UCSD-E4E/coral-reef-mapping/photos/IMG-0437.JPG

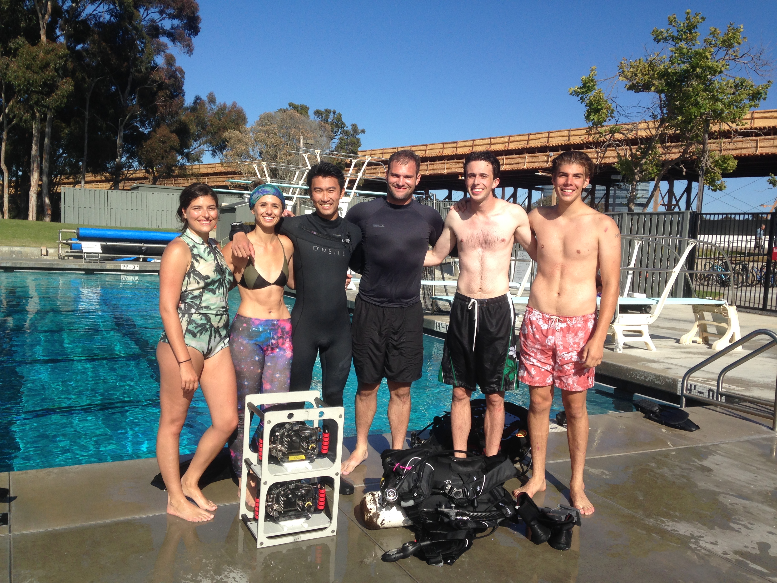
photos/IMG-0437.JPG
