UCSD-E4E/coral-reef-mapping/photos/IMG-0438.JPG

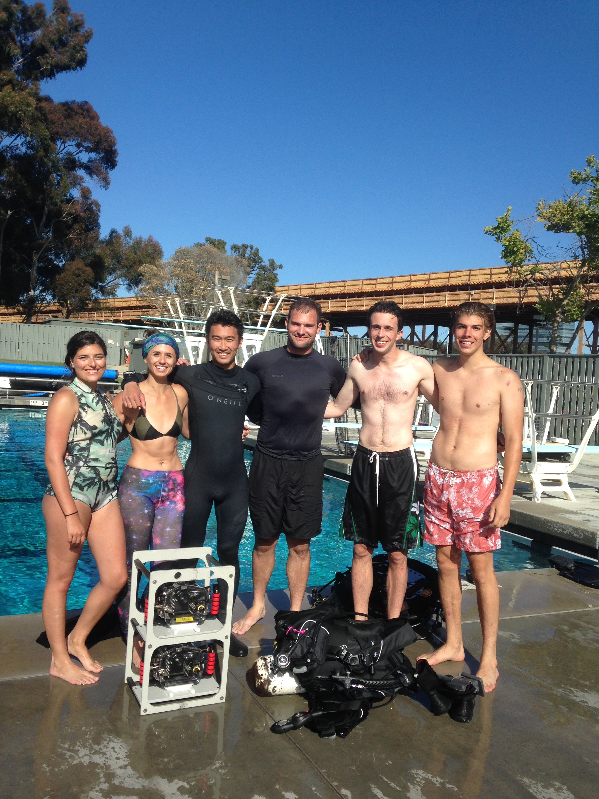
photos/IMG-0438.JPG
