UCSD-E4E/coral-reef-mapping/README.md

# coral-reef-mapping
Underwater depth/heading sensor for use by SIO oceanographers in mapping coral reefs.
