UCSD-E4E/coral-reef-mapping/photos/README.md

Some photos we accumulated. Probably good to keep track of any sort of media we create.
