UCSD-E4E/coral-reef-mapping/hardware/datasheets/README.md

This section contains a bunch of relevant datasheets, as well as other information about using the MSP 430. Datasheets can also be found by going to the various Mouser pages for the parts - URLs can be found on the BOM. Some datasheets are missing; feel free to add them.
