UCSD-E4E/coral-reef-mapping/photos/Overview.pdf

# Reefer

## The

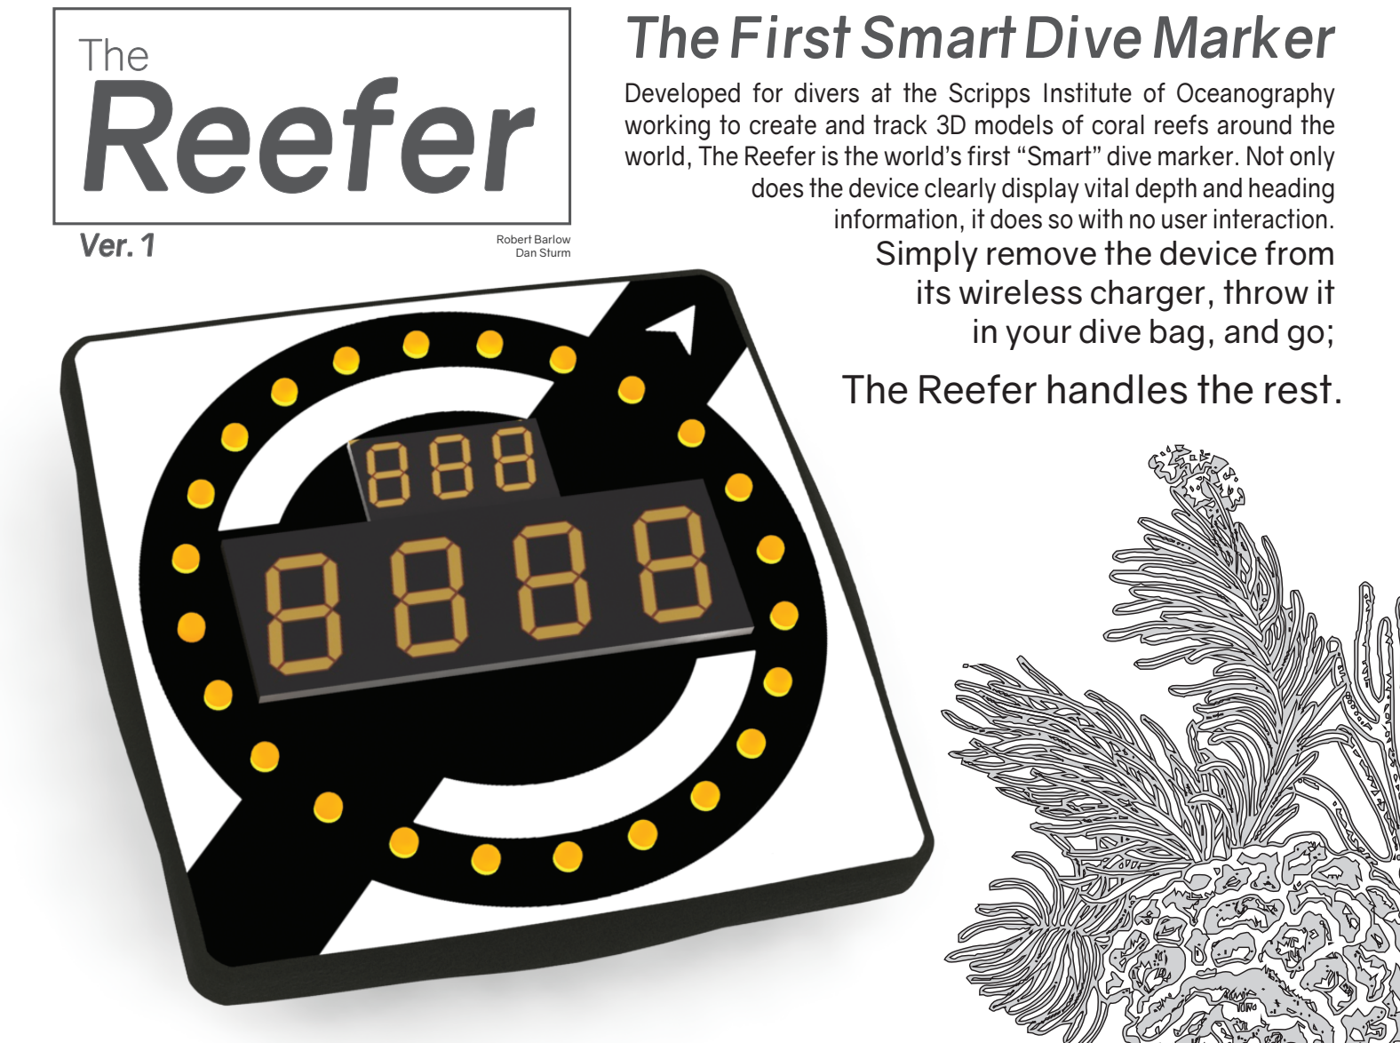
[picture p3: page 1]

Ver. 1 | Robert Barlow Dan Sturm

# The First Smart Dive Marker

Developed for divers at the Scripps Institute of Oceanography working to create and track 3D models of coral reefs around the world, The Reefer is the world’s first “Smart” dive marker. Not only does the device clearly display vital depth and heading information, it does so with no user interaction.

### Simply remove the device from its wireless charger, throw it

in your dive bag, and go;
The Reefer handles the rest.
