UCSD-E4E/coral-reef-mapping/photos/Flow Diagrm.pdf

O

Ultra-low power consumption state. All devices turned o, MSP set to low power mode.

Magnetometer | Pressure

Reed Switch

Magnetometer is disabled Pressure Sensor is disabled

# On (Flux)

Instantaneous depth state. Used when device is in transit from boat to dive location and back.

Magnetometer | Pressure

Reed Switch

Reading is displayed directly on
main display, and is not saved.

Reading is displayed directly on main display, and is not saved.

# Report

Past data display state. Used at end of dive to read back heading and depth information. Also used to display charge state.

Magnetometer | Pressure

Reed Switch

Saved magnetometer reading
is displayed

Saved pressure reading
is displayed

# On (Stable)

General use state. Used when device is permanantly seated in place. Device should be in this state for all images.

Magnetometer | Pressure

Reed Switch

Reading is time averaged over
~3 mins, displayed and saved
for later display in report mode.

Reading is displayed and saved for later display in report mode.

Magnet is used
to engage reed
switch

Magnet is
removed

Device is
submerged

Device is
taken out
of water

Heading is
maintained for
>1 minute

Heading is
disrupted by
~30 degrees

# Reefer

# The

# Functional Flow Diagram

# Robert Barlow and Dan Sturm
