UCSD-E4E/coral-reef-mapping/photos/RenderViewOne.pdf

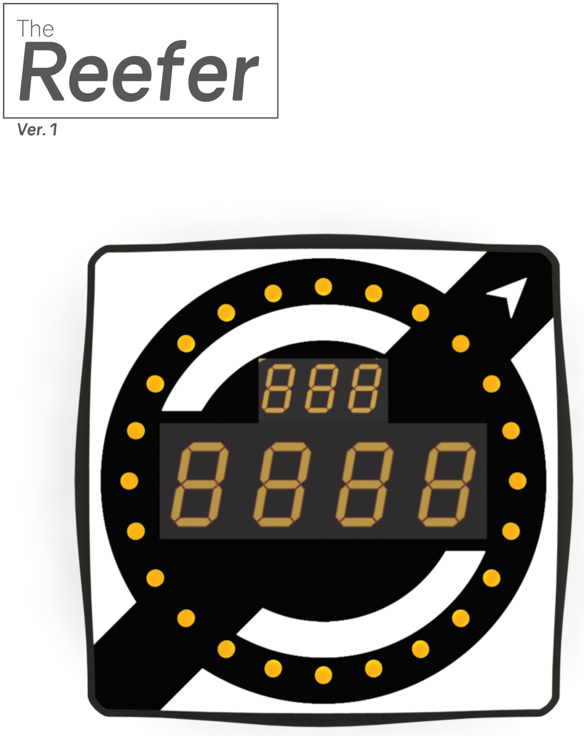
[picture p4: page 1]
