UCSD-E4E/coral-reef-mapping/BOM/currentBOM.xlsx

Function | Quantity | Ind. Price | Tot Price | Blk Ind. Price | Blk Tot. Price | URL | Blk Amount | Note | Specifics
Battery | 1 | 12.95 | 12.95 | 12.95 | 12.95 | https://www.sparkfun.com/products/13855 | 1 |  | 2Ah Li-ion
Battery Management IC | 1 | 0.58 | 0.58 | 0.569 | 0.569 | https://www.mouser.com/ProductDetail/Microchip-Technology/MCP73831T-2ACI-OT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 | 10 |  | Regulates charging, maybe some other stuff
Qi Receiver Module | 1 | 14.95 | 14.95 | 14.95 | 14.95 | https://www.mouser.com/ProductDetail/Adafruit/1901 | 1 |  | 5V, 500 mA
Voltage Regulator | 1 | 1.01 | 1.01 | 0.995 | 0.995 | https://www.mouser.com/ProductDetail/Microchip-Technology/MCP1826S-3302E-AB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 | 10 |  | Gives 3.3V
Diode | 1 | 0.39 | 0.39 | 0.268 | 0.268 | https://www.mouser.com/ProductDetail/STMicroelectronics/1N5817 | 10 |  | For voltage regulation
PMOS | 1 | 1.89 | 1.89 | 1.61 | 1.61 | https://www.mouser.com/ProductDetail/Infineon-Technologies/IPP80P03P4L-04 | 10 |  | For voltage regulation
Reed Switches | 1 | 1.08 | 1.08 | 0.95 | 0.95 | https://www.mouser.com/ProductDetail/Hamlin-Littelfuse/FLEX-14-20-25 | 10
 |  |  |  |  | 0
Magnetometer | 1 | 1.62 | 1.62 | 1.38 | 1.38 | https://www.mouser.com/ProductDetail/STMicroelectronics/LIS3MDLTR?qs=hnsWAVXnr6EbLE48dGN9Pg%3d%3d | 10
Pressure (Depth) Sensor | 1 | 21.82 | 21.82 | 20.78 | 20.78 | https://www.mouser.com/ProductDetail/Measurement-Specialties/MS580314BA01-00 | 5
Pressure Sensor Breakout | 1 | 2.95 | 2.95 | 2.95 | 2.95 | https://www.mouser.com/ProductDetail/Adafruit/1212 | 1 | Pack of 6
 |  |  |  |  | 0
LED 7-Segment (one digit) | 4 | 2.35 | 9.4 | 1.65 | 6.6 | https://www.mouser.com/ProductDetail/Kingbright/SC08-11YWA?qs=sGAEpiMZZMvkC18yXH9iIjoyVwNe42b3wDB5JTN4wUI%3d | 25 | Brighter version: http://www.newark.com/kingbright/sc08-11sekwa/display-0-8-cmn-cathode-orange/dp/83T3153 | Yellow, common cathode
LED 7-Segment (three digits) | 1 | 5.18 | 5.18 | 4.31 | 4.31 | https://www.mouser.com/ProductDetail/Kingbright/BC56-11YWA?qs=VdjlWU%2fzoOEXB6QVupy90w%3d%3d | 10 | Brighter version: http://www.newark.com/kingbright/bc56-11sykwa/display-led-0-56-yellow-common/dp/96W6817 | Yellow, common cathode
LED 7-Segment Driver A | 1 | 7.27 | 7.27 | 6.9 | 6.9 | https://www.mouser.com/ProductDetail/Maxim-Integrated/MAX6958AAPE%2b | 10 | We need to have to have BOTH of these drivers so they have different addresses | Uses multiplexing, common cathode
LED 7-Segment Driver B | 1 | 7.27 | 7.27 | 6.9 | 6.9 | https://www.mouser.com/ProductDetail/Maxim-Integrated/MAX6958BAPE%2b | 10 |  | Uses multiplexing, common cathode
Single LEDs | 24 | 0.21 | 5.04 | 0.121 | 2.904 | https://www.mouser.com/ProductDetail/Lumex/SSL-LX5093SOD?qs=sGAEpiMZZMtmwHDZQCdlqVsz6Sp3LtaXrDWdPJgw9fM%3d | 100 |  | Orange
Single LED Driver | 3 | 1.28 | 3.84 | 1.02 | 3.06 | https://www.mouser.com/ProductDetail/Texas-Instruments/TPIC2810DR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 | 10 | But cut tape to avoid upfront cost
100 Ohm Resistor | 24 | 0.1 | 2.4 | 0.012 | 0.288 |  | 100
Microcontroller | 1 | 2.09 | 2.09 | 1.77 | 1.77 | https://www.mouser.com/ProductDetail/?qs=cH06ZXzI8SHFq7c9KM3lkw%3d%3d | 10
PCB | 1 | 5 | 5 | 5 | 5
 |  |  |  |  | 0
DIP16 | 2 | 0.22 | 0.44 | 0.182 | 0.364 | https://www.mouser.com/ProductDetail/TE-Connectivity/1-2199298-4 | 10
DIP20 | 2 | 0.37 | 0.74 | 0.302 | 0.604 | https://www.mouser.com/ProductDetail/Amphenol-FCI/DILB20P-223TLF | 25
 |  | Total Cost: | 107.91 | Total Cost | 96.102
Resistors | https://www.amazon.com/Ltvystore-2600pcs-130-Values-ohm/dp/B06XDP3ZGT
Capacitors | Small caps: | https://www.amazon.com/Hilitchi-Monolithic-Multilayer-Capacitors-Assortment/dp/B071P44QBH
 | Large caps: | https://www.amazon.com/Ltvystore-Electrolytic-Capacitors-Assortment-0-1uF%EF%BC%8D220uF/dp/B01H1W6VV6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
Qi Transmitter | https://www.amazon.com/SUVIUS-Wireless-Charger-iPhone-Samsung/dp/B078WXSBTR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
