UCSD-E4E/coral-reef-mapping/pcb/1V0/REEF_1V0.brd

## EAGLE design pcb/1V0/REEF_1V0.brd (2018-09-17)

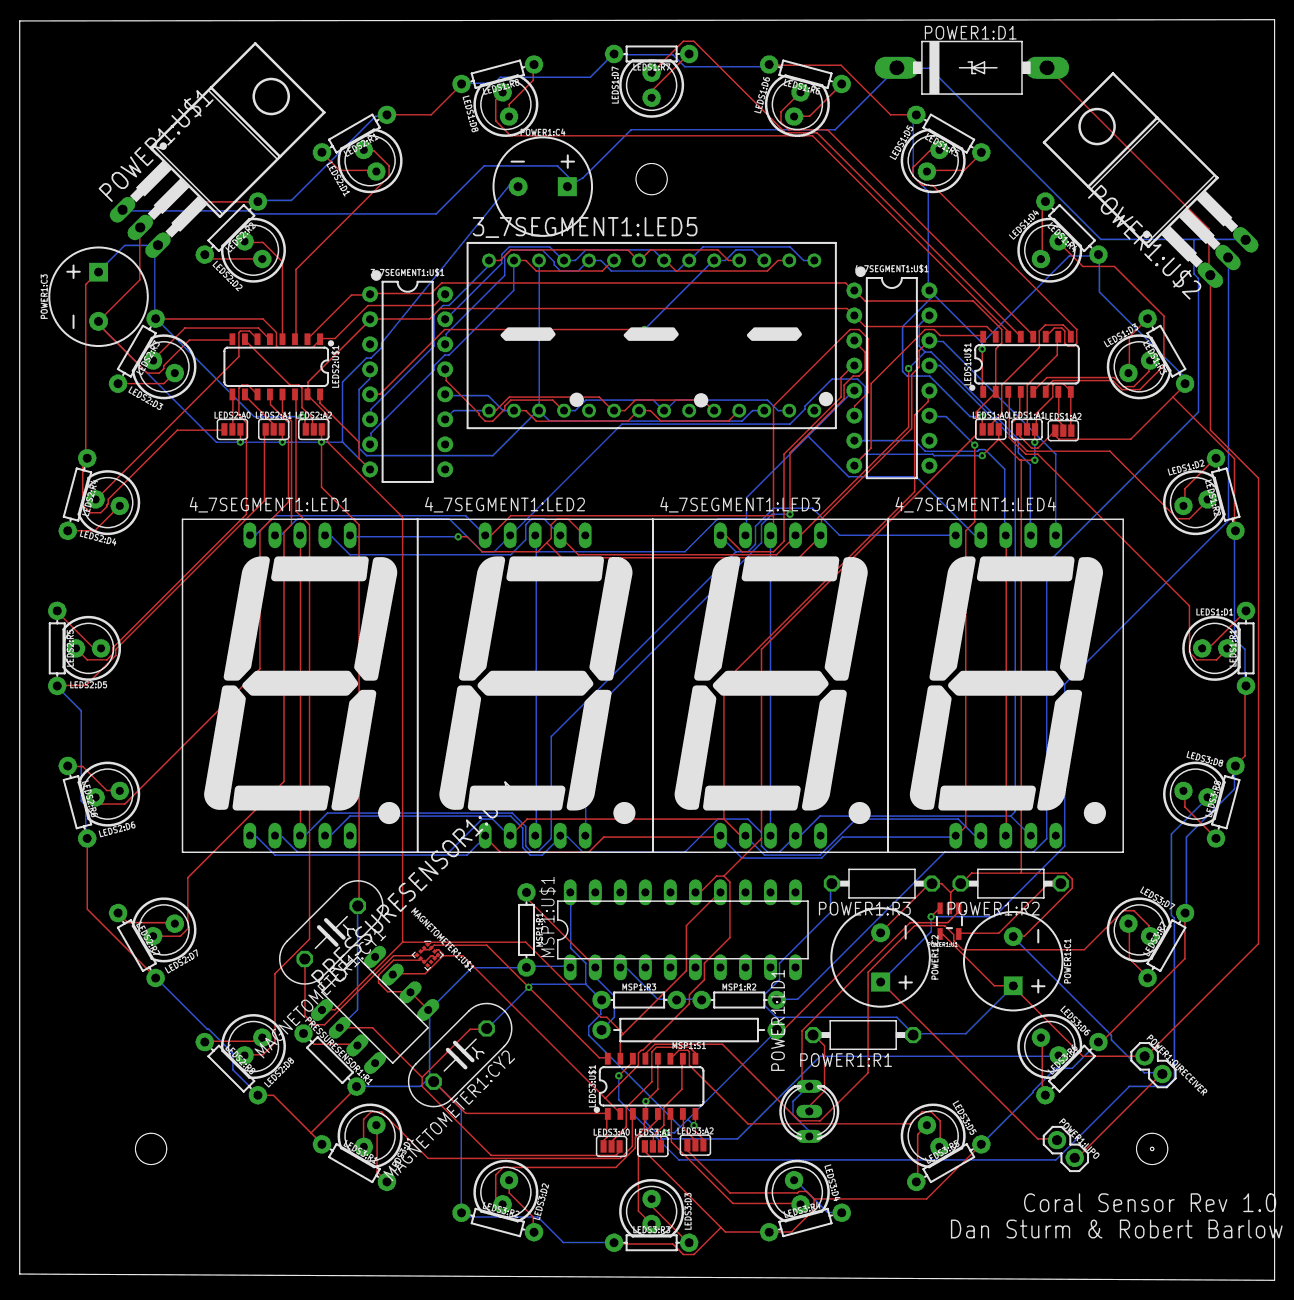
[picture p5: board REEF_1V0.brd from above]

Board: 2 copper layers, 127.4 x 127.9 mm, 91 parts (0 on the bottom side), 90 nets.

Parts:
3_7SEGMENT1:LED5: BA56-11EWA; BA/BC56
3_7SEGMENT1:U$1, 4_7SEGMENT1:U$1: MAX6958BAPE+; DIP16
4_7SEGMENT1:LED1, 4_7SEGMENT1:LED2, 4_7SEGMENT1:LED3, 4_7SEGMENT1:LED4: 7-SEG_SA10-21; SA10-21
LEDS1:A0, LEDS1:A1, LEDS1:A2, LEDS2:A0, LEDS2:A1, LEDS2:A2, LEDS3:A0, LEDS3:A1, LEDS3:A2: SMT-JUMPER_3_NO_SILK
LEDS1:D1, LEDS1:D2, LEDS1:D3, LEDS1:D4, LEDS1:D5, LEDS1:D6, LEDS1:D7, LEDS1:D8, LEDS2:D1, LEDS2:D2, LEDS2:D3, LEDS2:D4, LEDS2:D5, LEDS2:D6, LEDS2:D7, LEDS2:D8, LEDS3:D1, LEDS3:D2, LEDS3:D3, LEDS3:D4, LEDS3:D5, LEDS3:D6, LEDS3:D7, LEDS3:D8: LED_5MM
LEDS1:R1, LEDS1:R2, LEDS1:R3, LEDS1:R4, LEDS1:R5, LEDS1:R6, LEDS1:R7, LEDS1:R8, LEDS2:R1, LEDS2:R2, LEDS2:R3, LEDS2:R4, LEDS2:R5, LEDS2:R6, LEDS2:R7, LEDS2:R8, LEDS3:R1, LEDS3:R2, LEDS3:R3, LEDS3:R4, LEDS3:R5, LEDS3:R6, LEDS3:R7, LEDS3:R8: 100; AXIAL-0.3
LEDS1:U$1, LEDS2:U$1, LEDS3:U$1: TPIC2810D; SO16
MAGNETOMETER1:CY1, MAGNETOMETER1:CY2: 100nF; YC7B5
MAGNETOMETER1:U$1: LGA-12
MSP1:R1: 100K; AXIAL-0.3
MSP1:R2, MSP1:R3: 100k; AXIAL-0.3
MSP1:S1: REED_SWITCH-PTH-GLASS; REED_SWITCH_GLASS
MSP1:U$1: MSP430G2452IN20; DIL20
POWER1:C1, POWER1:C2: 4.7uF; CPOL-RADIAL-5MM-10MM
POWER1:C3, POWER1:C4: 1uF; CPOL-RADIAL-5MM-10MM
POWER1:D1: 1N5908; C4111-15
POWER1:LD1: DUOLED-A-5MM
POWER1:LIPO, POWER1:QIRECEIVER: 1X02
POWER1:R1: 470; VMTA55
POWER1:R2: 2K; VMTA55
POWER1:R3: 100K; VMTA55
POWER1:U1: MCP73831; SOT23-5
POWER1:U$1: MCP1826S; T03B
POWER1:U$2: IPP80P03P4L-04; T03B
PRESSURESENSOR1:R1: 10k; AXIAL-0.3
PRESSURESENSOR1:U$1: MS5803-14BA; DIL8

Connections:
3.3V: 3_7SEGMENT1:U$1.16, 4_7SEGMENT1:U$1.16, LEDS1:A0.1, LEDS1:A1.1, LEDS1:A2.1, LEDS1:R1.P$1, LEDS1:R2.P$1, LEDS1:R3.P$1, LEDS1:R4.P$1, LEDS1:R5.P$2, LEDS1:R6.P$2, LEDS1:R7.P$2, LEDS1:R8.P$2, LEDS1:U$1.1, LEDS2:A0.1, LEDS2:A1.1, LEDS2:A2.1, LEDS2:R1.P$1, LEDS2:R2.P$1, LEDS2:R3.P$1, LEDS2:R4.P$1, LEDS2:R5.P$2, LEDS2:R6.P$2, LEDS2:R7.P$2, LEDS2:R8.P$2, LEDS2:U$1.1, LEDS3:A0.1, LEDS3:A1.1, LEDS3:A2.1, LEDS3:R1.P$1, LEDS3:R2.P$1, LEDS3:R3.P$1, LEDS3:R4.P$1, LEDS3:R5.P$2, LEDS3:R6.P$2, LEDS3:R7.P$2, LEDS3:R8.P$2, LEDS3:U$1.1, MAGNETOMETER1:CY2.2, MAGNETOMETER1:U$1.5, MAGNETOMETER1:U$1.6, MAGNETOMETER1:U$1.9, MAGNETOMETER1:U$1.10, MSP1:R1.P$2, MSP1:U$1.1, POWER1:C3.+, POWER1:U$1.3, PRESSURESENSOR1:R1.P$2, PRESSURESENSOR1:U$1.5, PRESSURESENSOR1:U$1.6
3_7SEGMENT1:N$1: 3_7SEGMENT1:LED5.3, 3_7SEGMENT1:LED5.12, 3_7SEGMENT1:LED5.26, 3_7SEGMENT1:U$1.4
3_7SEGMENT1:N$8: 3_7SEGMENT1:LED5.16, 3_7SEGMENT1:LED5.21, 3_7SEGMENT1:LED5.25, 3_7SEGMENT1:U$1.15
3_7SEGMENT1:N$9: 3_7SEGMENT1:LED5.15, 3_7SEGMENT1:LED5.20, 3_7SEGMENT1:LED5.24, 3_7SEGMENT1:U$1.14
3_7SEGMENT1:N$10: 3_7SEGMENT1:LED5.4, 3_7SEGMENT1:LED5.8, 3_7SEGMENT1:LED5.13, 3_7SEGMENT1:U$1.13
3_7SEGMENT1:N$11: 3_7SEGMENT1:LED5.2, 3_7SEGMENT1:LED5.7, 3_7SEGMENT1:LED5.11, 3_7SEGMENT1:U$1.12
3_7SEGMENT1:N$26: 3_7SEGMENT1:LED5.1, 3_7SEGMENT1:LED5.6, 3_7SEGMENT1:LED5.10, 3_7SEGMENT1:U$1.11
3_7SEGMENT1:N$28: 3_7SEGMENT1:LED5.17, 3_7SEGMENT1:LED5.19, 3_7SEGMENT1:U$1.5
3_7SEGMENT1:N$29: 3_7SEGMENT1:LED5.23, 3_7SEGMENT1:LED5.27, 3_7SEGMENT1:U$1.7
3_7SEGMENT1:N$30: 3_7SEGMENT1:LED5.18, 3_7SEGMENT1:LED5.22, 3_7SEGMENT1:LED5.28, 3_7SEGMENT1:U$1.6
4_7SEGMENT1:N$1: 4_7SEGMENT1:LED1.7, 4_7SEGMENT1:LED2.7, 4_7SEGMENT1:LED3.7, 4_7SEGMENT1:LED4.7, 4_7SEGMENT1:U$1.15
4_7SEGMENT1:N$2: 4_7SEGMENT1:LED1.6, 4_7SEGMENT1:LED2.6, 4_7SEGMENT1:LED3.6, 4_7SEGMENT1:LED4.6, 4_7SEGMENT1:U$1.14
4_7SEGMENT1:N$3: 4_7SEGMENT1:LED1.4, 4_7SEGMENT1:LED2.4, 4_7SEGMENT1:LED3.4, 4_7SEGMENT1:LED4.4, 4_7SEGMENT1:U$1.13
4_7SEGMENT1:N$4: 4_7SEGMENT1:LED1.2, 4_7SEGMENT1:LED2.2, 4_7SEGMENT1:LED3.2, 4_7SEGMENT1:LED4.2, 4_7SEGMENT1:U$1.12
4_7SEGMENT1:N$5: 4_7SEGMENT1:LED1.1, 4_7SEGMENT1:LED2.1, 4_7SEGMENT1:LED3.1, 4_7SEGMENT1:LED4.1, 4_7SEGMENT1:U$1.11
4_7SEGMENT1:N$6: 4_7SEGMENT1:LED1.3, 4_7SEGMENT1:LED1.8, 4_7SEGMENT1:LED3.10, 4_7SEGMENT1:LED4.10, 4_7SEGMENT1:U$1.4
4_7SEGMENT1:N$7: 4_7SEGMENT1:LED2.3, 4_7SEGMENT1:LED2.8, 4_7SEGMENT1:LED3.9, 4_7SEGMENT1:LED4.9, 4_7SEGMENT1:U$1.5
4_7SEGMENT1:N$8: 4_7SEGMENT1:LED2.5, 4_7SEGMENT1:U$1.3
4_7SEGMENT1:N$9: 4_7SEGMENT1:LED1.9, 4_7SEGMENT1:LED2.9, 4_7SEGMENT1:LED4.3, 4_7SEGMENT1:LED4.8, 4_7SEGMENT1:U$1.7
4_7SEGMENT1:N$11: 4_7SEGMENT1:LED1.10, 4_7SEGMENT1:LED2.10, 4_7SEGMENT1:LED3.3, 4_7SEGMENT1:LED3.8, 4_7SEGMENT1:U$1.6
GND: 3_7SEGMENT1:U$1.8, 4_7SEGMENT1:U$1.8, LEDS1:A0.3, LEDS1:A1.3, LEDS1:A2.3, LEDS1:U$1.8, LEDS1:U$1.16, LEDS2:A0.3, LEDS2:A1.3, LEDS2:A2.3, LEDS2:U$1.8, LEDS2:U$1.16, LEDS3:A0.3, LEDS3:A1.3, LEDS3:A2.3, LEDS3:U$1.8, LEDS3:U$1.16, MAGNETOMETER1:CY1.1, MAGNETOMETER1:CY2.1, MAGNETOMETER1:U$1.2, MAGNETOMETER1:U$1.3, MAGNETOMETER1:U$1.12, MSP1:R3.P$1, MSP1:S1.P$1, MSP1:U$1.20, POWER1:C1.-, POWER1:C2.-, POWER1:C3.-, POWER1:C4.-, POWER1:LIPO.2, POWER1:QIRECEIVER.2, POWER1:R2.2, POWER1:R3.1, POWER1:U1.2, POWER1:U$1.2, PRESSURESENSOR1:U$1.2
LEDS1:N$1: LEDS1:D1.K, LEDS1:U$1.3
LEDS1:N$2: LEDS1:D2.K, LEDS1:U$1.4
LEDS1:N$3: LEDS1:D3.K, LEDS1:U$1.5
LEDS1:N$4: LEDS1:D4.K, LEDS1:U$1.6
LEDS1:N$5: LEDS1:D5.K, LEDS1:U$1.11
LEDS1:N$6: LEDS1:D6.K, LEDS1:U$1.12
LEDS1:N$7: LEDS1:D7.K, LEDS1:U$1.13
LEDS1:N$8: LEDS1:D8.K, LEDS1:U$1.14
LEDS1:N$9: LEDS1:A2.2, LEDS1:U$1.7
LEDS1:N$10: LEDS1:A1.2, LEDS1:U$1.10
LEDS1:N$11: LEDS1:A0.2, LEDS1:U$1.9
LEDS1:N$12: LEDS1:D5.A, LEDS1:R5.P$1
LEDS1:N$13: LEDS1:D6.A, LEDS1:R6.P$1
LEDS1:N$14: LEDS1:D7.A, LEDS1:R7.P$1
LEDS1:N$15: LEDS1:D8.A, LEDS1:R8.P$1
LEDS1:N$16: LEDS1:D1.A, LEDS1:R1.P$2
LEDS1:N$18: LEDS1:D2.A, LEDS1:R2.P$2
LEDS1:N$19: LEDS1:D3.A, LEDS1:R3.P$2
LEDS1:N$20: LEDS1:D4.A, LEDS1:R4.P$2
LEDS2:N$1: LEDS2:D1.K, LEDS2:U$1.3
LEDS2:N$2: LEDS2:D2.K, LEDS2:U$1.4
LEDS2:N$3: LEDS2:D3.K, LEDS2:U$1.5
LEDS2:N$4: LEDS2:D4.K, LEDS2:U$1.6
LEDS2:N$5: LEDS2:D5.K, LEDS2:U$1.11
LEDS2:N$6: LEDS2:D6.K, LEDS2:U$1.12
LEDS2:N$7: LEDS2:D7.K, LEDS2:U$1.13
LEDS2:N$8: LEDS2:D8.K, LEDS2:U$1.14
LEDS2:N$9: LEDS2:A2.2, LEDS2:U$1.7
LEDS2:N$10: LEDS2:A1.2, LEDS2:U$1.10
LEDS2:N$11: LEDS2:A0.2, LEDS2:U$1.9
LEDS2:N$12: LEDS2:D5.A, LEDS2:R5.P$1
LEDS2:N$13: LEDS2:D6.A, LEDS2:R6.P$1
LEDS2:N$14: LEDS2:D7.A, LEDS2:R7.P$1
LEDS2:N$15: LEDS2:D8.A, LEDS2:R8.P$1
LEDS2:N$16: LEDS2:D1.A, LEDS2:R1.P$2
LEDS2:N$18: LEDS2:D2.A, LEDS2:R2.P$2
LEDS2:N$19: LEDS2:D3.A, LEDS2:R3.P$2
LEDS2:N$20: LEDS2:D4.A, LEDS2:R4.P$2
LEDS3:N$1: LEDS3:D1.K, LEDS3:U$1.3
LEDS3:N$2: LEDS3:D2.K, LEDS3:U$1.4
LEDS3:N$3: LEDS3:D3.K, LEDS3:U$1.5
LEDS3:N$4: LEDS3:D4.K, LEDS3:U$1.6
LEDS3:N$5: LEDS3:D5.K, LEDS3:U$1.11
LEDS3:N$6: LEDS3:D6.K, LEDS3:U$1.12
LEDS3:N$7: LEDS3:D7.K, LEDS3:U$1.13
LEDS3:N$8: LEDS3:D8.K, LEDS3:U$1.14
LEDS3:N$9: LEDS3:A2.2, LEDS3:U$1.7
LEDS3:N$10: LEDS3:A1.2, LEDS3:U$1.10
LEDS3:N$11: LEDS3:A0.2, LEDS3:U$1.9
LEDS3:N$12: LEDS3:D5.A, LEDS3:R5.P$1
LEDS3:N$13: LEDS3:D6.A, LEDS3:R6.P$1
LEDS3:N$14: LEDS3:D7.A, LEDS3:R7.P$1
LEDS3:N$15: LEDS3:D8.A, LEDS3:R8.P$1
LEDS3:N$16: LEDS3:D1.A, LEDS3:R1.P$2
LEDS3:N$18: LEDS3:D2.A, LEDS3:R2.P$2
LEDS3:N$19: LEDS3:D3.A, LEDS3:R3.P$2
LEDS3:N$20: LEDS3:D4.A, LEDS3:R4.P$2
MAGNETOMETER1:N$3: MAGNETOMETER1:CY1.2, MAGNETOMETER1:U$1.4
MSP1:N$1: MSP1:R1.P$1, MSP1:S1.P$2, MSP1:U$1.2
MSP1:N$2: MSP1:R2.P$1, MSP1:R3.P$2, MSP1:U$1.3
unnamed: MSP1:R2.P$2, POWER1:C4.+, POWER1:D1.C, POWER1:U$1.1, POWER1:U$2.3
POWER1:N$2: POWER1:C2.+, POWER1:LIPO.1, POWER1:U1.3, POWER1:U$2.2
POWER1:N$3: POWER1:LD1.CR, POWER1:LD1.CX, POWER1:U1.1
POWER1:N$4: POWER1:C1.+, POWER1:D1.A, POWER1:QIRECEIVER.1, POWER1:R1.1, POWER1:R3.2, POWER1:U1.4, POWER1:U$2.1
POWER1:N$6: POWER1:R2.1, POWER1:U1.5
POWER1:N$7: POWER1:LD1.A, POWER1:R1.2
PRESSURESENSOR1:N$1: PRESSURESENSOR1:R1.P$1, PRESSURESENSOR1:U$1.3
SCL: 3_7SEGMENT1:U$1.2, 4_7SEGMENT1:U$1.2, LEDS1:U$1.15, LEDS2:U$1.15, LEDS3:U$1.15, MAGNETOMETER1:U$1.1, MSP1:U$1.14, PRESSURESENSOR1:U$1.1
SDA: 3_7SEGMENT1:U$1.1, 4_7SEGMENT1:U$1.1, LEDS1:U$1.2, LEDS2:U$1.2, LEDS3:U$1.2, MAGNETOMETER1:U$1.11, MSP1:U$1.15, PRESSURESENSOR1:U$1.7
