UCSD-E4E/coral-reef-mapping/code/read_adc.c

#include <msp430.h>
#include <stdint.h>
#include <read_adc.h>

uint16_t adc_read(void)
{
  WDTCTL = WDTPW + WDTHOLD;                 // Stop WDT
  ADC10CTL0 = ADC10SHT_2 + ADC10ON + ADC10IE; // ADC10ON, interrupt enabled
  ADC10CTL1 = INCH_1;                       // input A1
  ADC10AE0 |= 0x02;                         // PA.1 ADC option select
  P1DIR |= 0x01;                            // Set P1.0 to output direction

  ADC10CTL0 |= ENC + ADC10SC;             // Sampling and conversion start
  __bis_SR_register(CPUOFF + GIE);        // LPM0, ADC10_ISR will force exit
  return(ADC10MEM);
}

// ADC10 interrupt service routine
#if defined(__TI_COMPILER_VERSION__) || defined(__IAR_SYSTEMS_ICC__)
#pragma vector=ADC10_VECTOR
__interrupt void ADC10_ISR(void)
#elif defined(__GNUC__)
void __attribute__ ((interrupt(ADC10_VECTOR))) ADC10_ISR (void)
#else
#error Compiler not supported!
#endif
{
  __bic_SR_register_on_exit(CPUOFF);        // Clear CPUOFF bit from 0(SR)
}
